Xavari/Projekt-robota-typu-SCARA/Złożenie.png

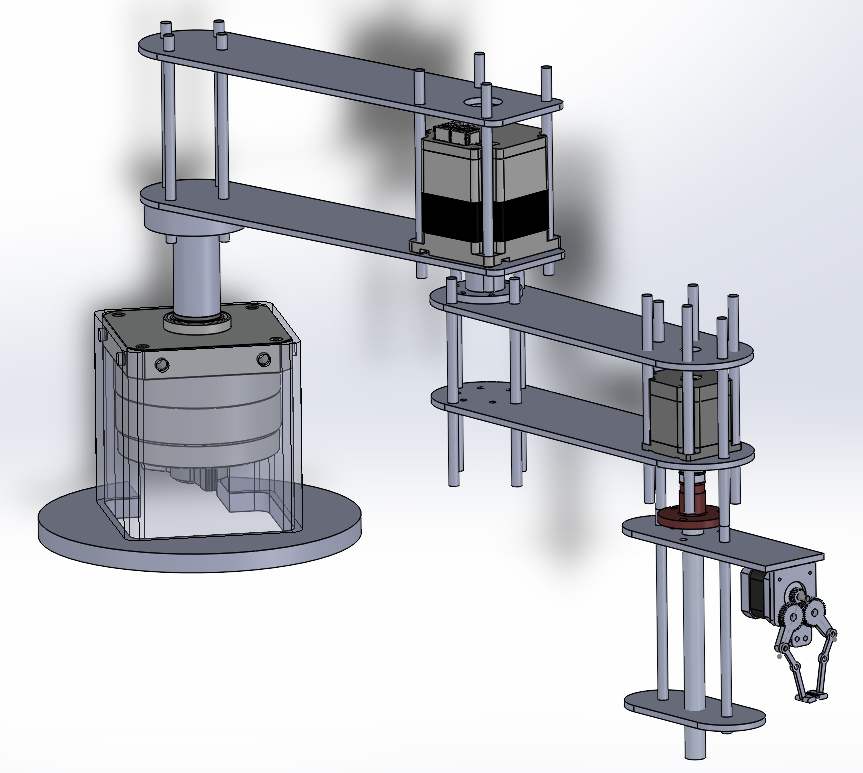
Złożenie.png
