Xavari/Projekt-robota-typu-SCARA/załączniki/screeny/5.png

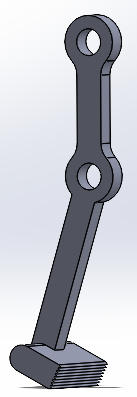
załączniki/screeny/5.png
