Xavari/Projekt-robota-typu-SCARA/README.md

# Projekt-robota-typu-SCARA
Praca ta zakłada zaprojektowanie robota typu SCARA wraz z wykonaniem odpowiednich symulacji w programie MATLAB. Wszelkie modele trójwymiarowe zostały wykonane za pomocą programu SolidWorks.
