Xavari/Projekt-robota-typu-SCARA/załączniki/Oznaczenia.png

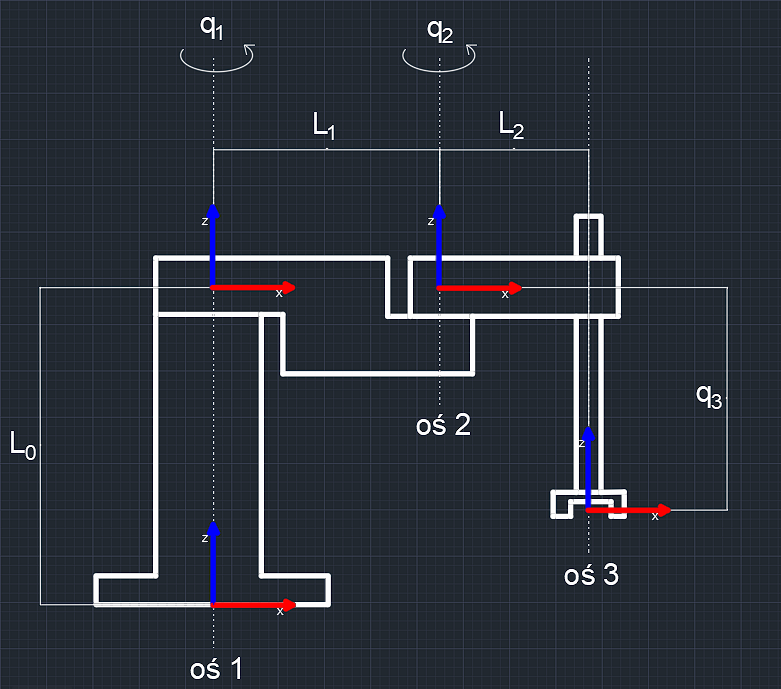
załączniki/Oznaczenia.png
