Xavari/Projekt-robota-typu-SCARA/załączniki/screeny/1.png

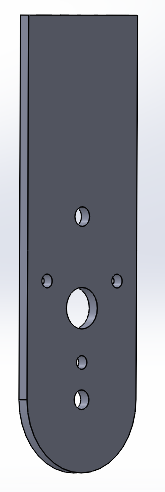
załączniki/screeny/1.png
