Xavari/Projekt-robota-typu-SCARA/załączniki/screeny/2.png

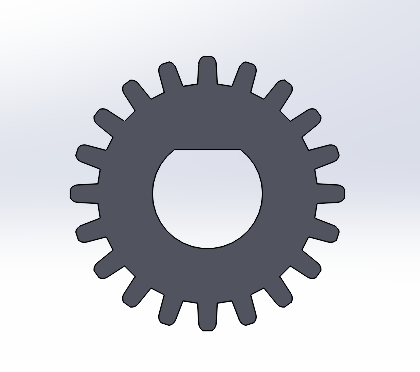
załączniki/screeny/2.png
