Xavari/Projekt-robota-typu-SCARA/załączniki/screeny/3.png

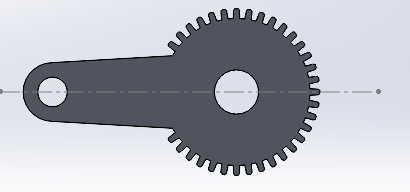
załączniki/screeny/3.png
