Xavari/Projekt-robota-typu-SCARA/załączniki/screeny/4.png

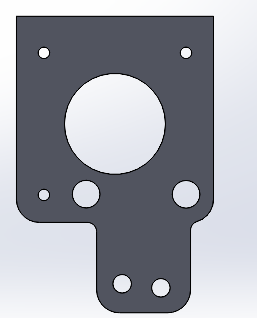
załączniki/screeny/4.png
