Xavari/Projekt-robota-typu-SCARA/załączniki/screeny/6.png

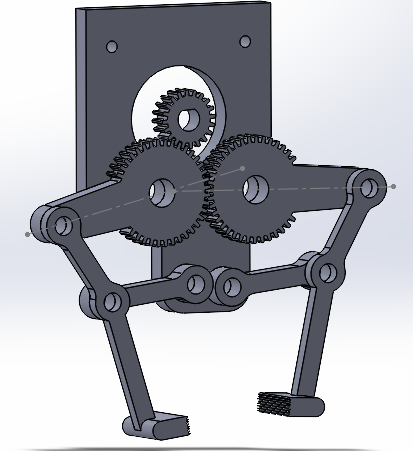
załączniki/screeny/6.png
