Xavari/Projekt-robota-typu-SCARA/załączniki/screeny/7.png

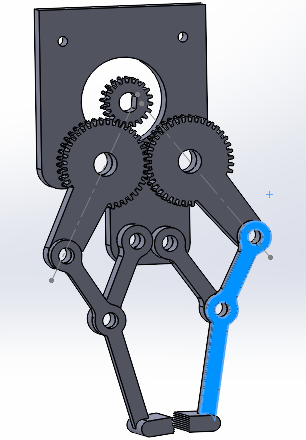
załączniki/screeny/7.png
