Xavari/Projekt-robota-typu-SCARA/załączniki/screeny/badanie ruchi_M_obr_os2.png

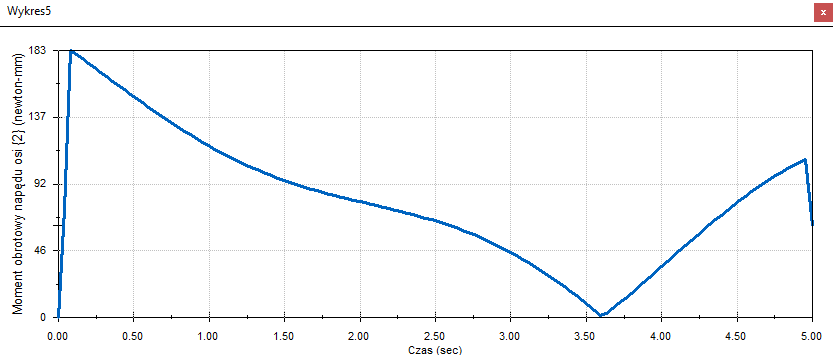
załączniki/screeny/badanie ruchi_M_obr_os2.png
