Xavari/Projekt-robota-typu-SCARA/załączniki/screeny/badanie ruchi_pr_k_chw.png

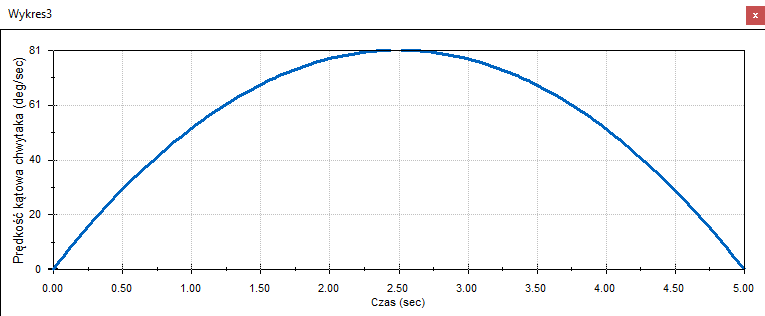
załączniki/screeny/badanie ruchi_pr_k_chw.png
