Xavari/Projekt-robota-typu-SCARA/załączniki/screeny/badanie ruchi_przemieszczenie.png

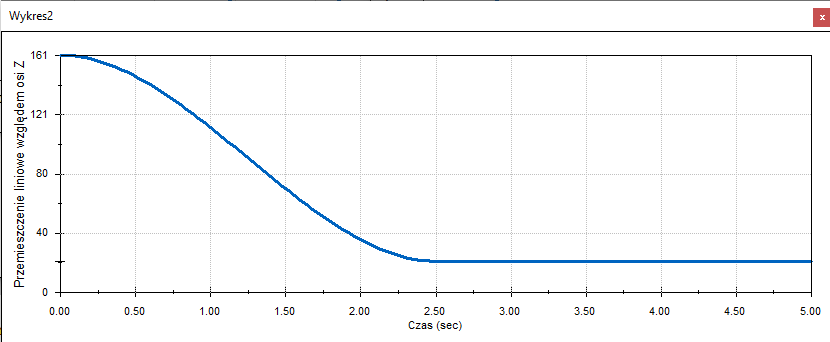
załączniki/screeny/badanie ruchi_przemieszczenie.png
