Xavari/Projekt-robota-typu-SCARA/załączniki/screeny/final1.png

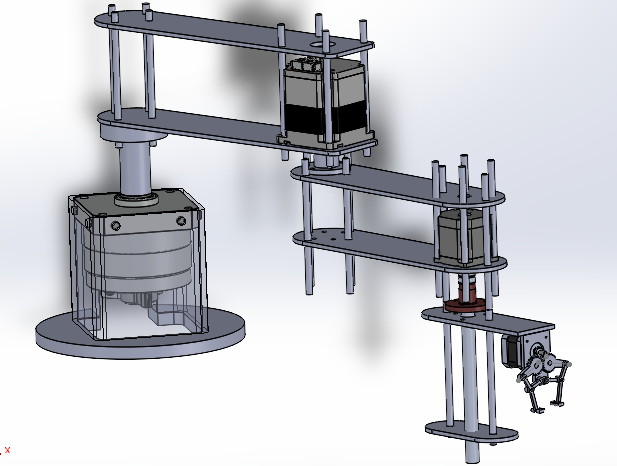
załączniki/screeny/final1.png
