Xavari/Projekt-robota-typu-SCARA/załączniki/AutoCAD/Drawing1-Model.pdf

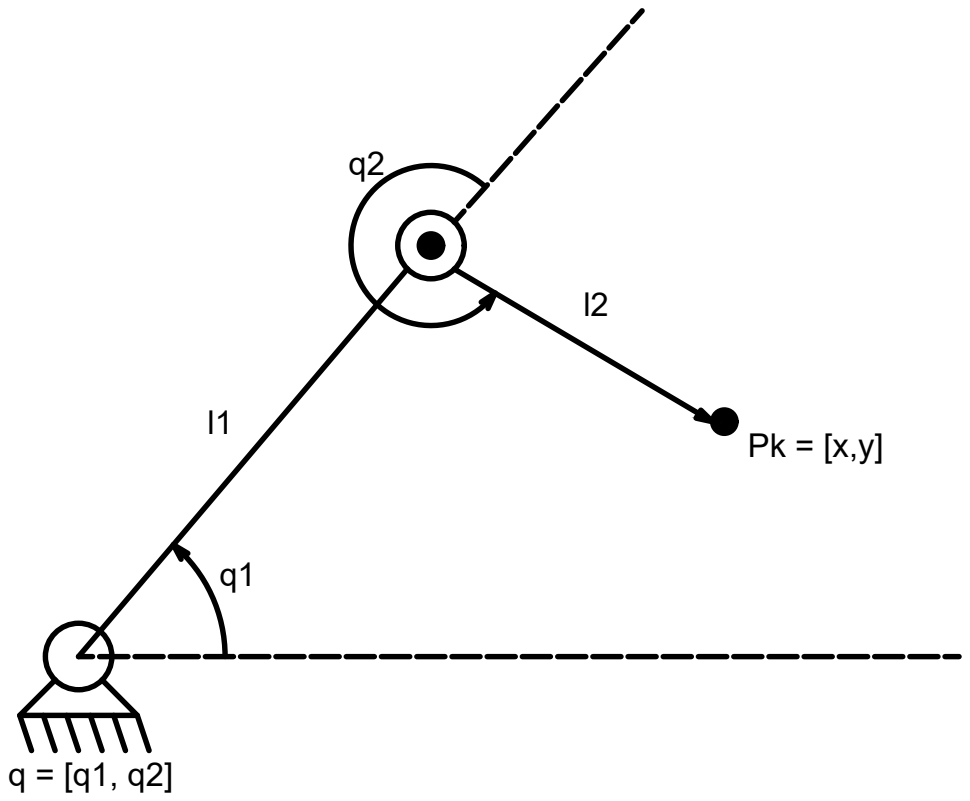
[picture p49: page 1]
