Xavari/Projekt-robota-typu-SCARA/załączniki/rysunek koncepcyjny OOP/koncept.SLDASM

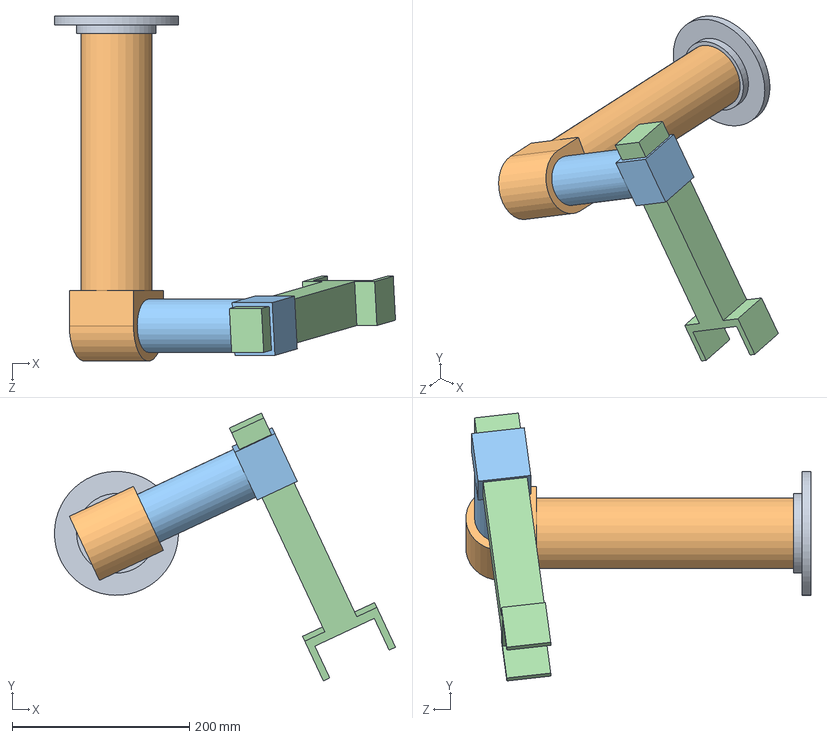
[picture p39: CAD file, 2024-03-20]
załączniki/rysunek koncepcyjny OOP/koncept.SLDASM
385.4 x 302.7 x 389.8 mm
podstawa_koncept
c1_koncept
c2_koncept
c3_koncept
