Xavari/Projekt-robota-typu-SCARA/załączniki/rysunek koncepcyjny SCARA/SCARA.SLDASM

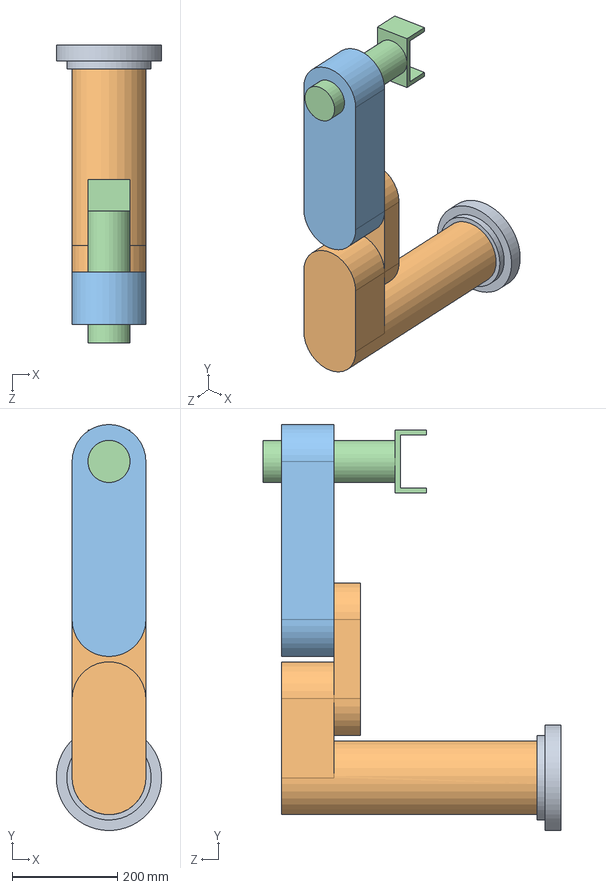
[picture p40: CAD file, 2024-03-20]
załączniki/rysunek koncepcyjny SCARA/SCARA.SLDASM
200.0 x 770.0 x 564.3 mm
C0
C1
C2
C3
