Xavari/Projekt-robota-typu-SCARA/załączniki/rysunek koncepcyjny OOP/c2_koncept.SLDPRT

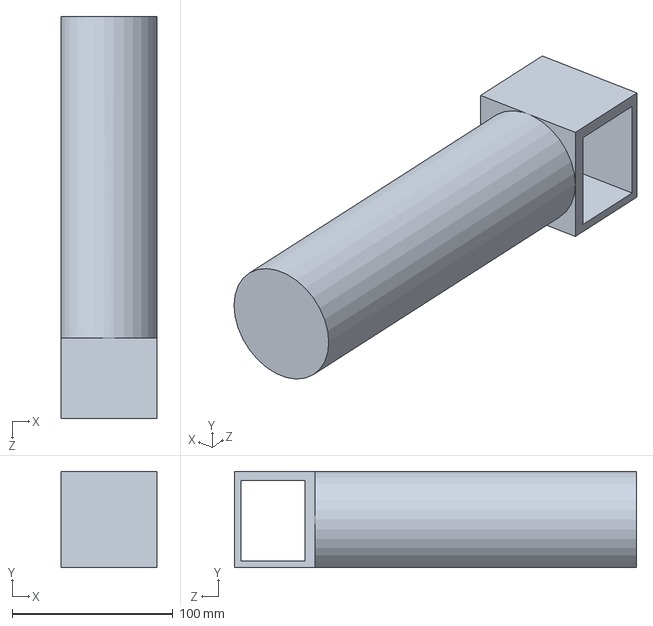
[picture p41: CAD file, 2024-03-20]
załączniki/rysunek koncepcyjny OOP/c2_koncept.SLDPRT
60.0 x 60.0 x 250.0 mm
