Xavari/Projekt-robota-typu-SCARA/załączniki/rysunek koncepcyjny SCARA/C2.SLDPRT

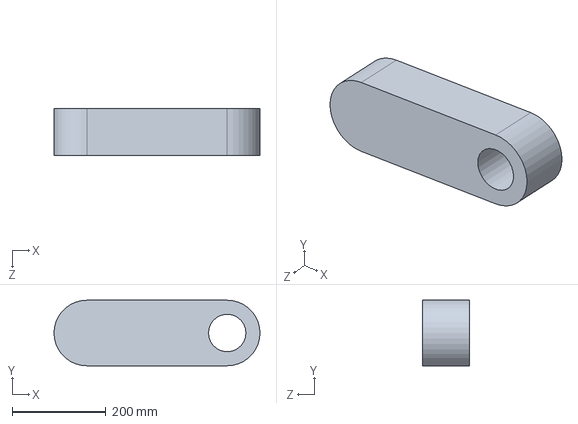
[picture p42: CAD file, 2024-03-20]
załączniki/rysunek koncepcyjny SCARA/C2.SLDPRT
440.0 x 140.0 x 100.0 mm
