Xavari/Projekt-robota-typu-SCARA/załączniki/rysunek koncepcyjny OOP/podstawa_koncept.SLDPRT

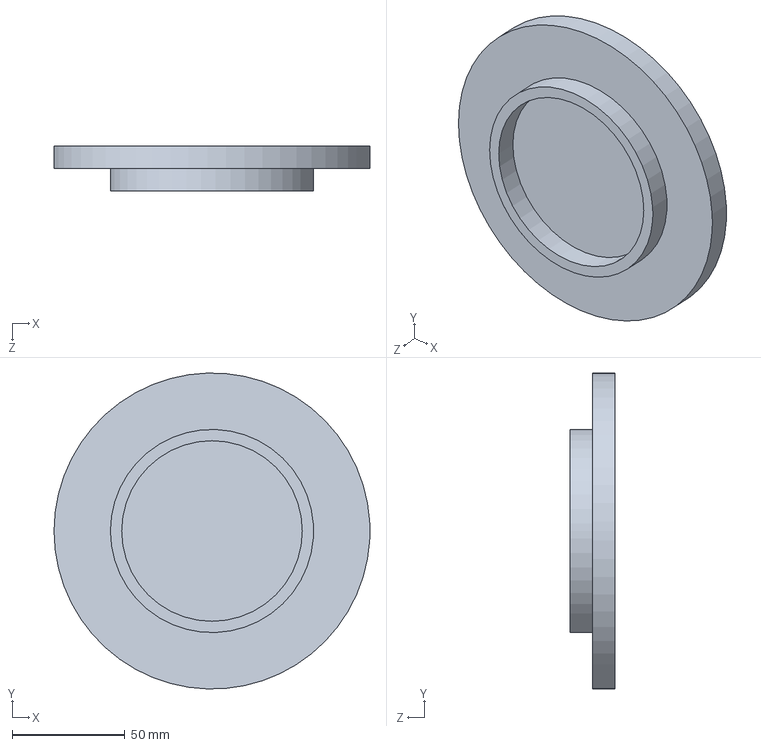
[picture p43: CAD file, 2024-03-20]
załączniki/rysunek koncepcyjny OOP/podstawa_koncept.SLDPRT
140.0 x 139.9 x 20.0 mm
