Xavari/Projekt-robota-typu-SCARA/załączniki/rysunek koncepcyjny SCARA/C0.SLDPRT

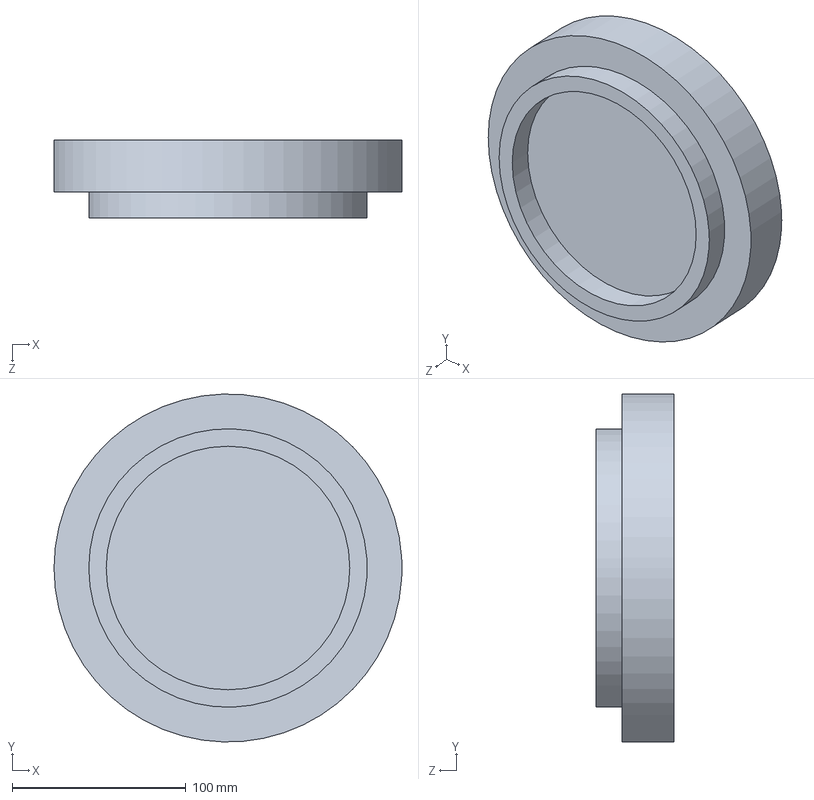
[picture p44: CAD file, 2024-03-20]
załączniki/rysunek koncepcyjny SCARA/C0.SLDPRT
200.0 x 199.9 x 45.0 mm
