Xavari/Projekt-robota-typu-SCARA/załączniki/rysunek koncepcyjny OOP/c1_koncept.SLDPRT

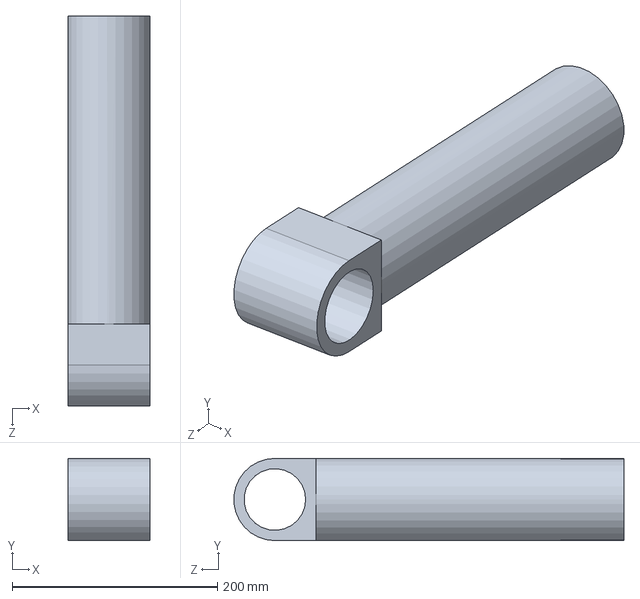
[picture p45: CAD file, 2024-03-20]
załączniki/rysunek koncepcyjny OOP/c1_koncept.SLDPRT
80.0 x 80.0 x 379.8 mm
