Xavari/Projekt-robota-typu-SCARA/załączniki/rysunek koncepcyjny SCARA/C3.SLDPRT

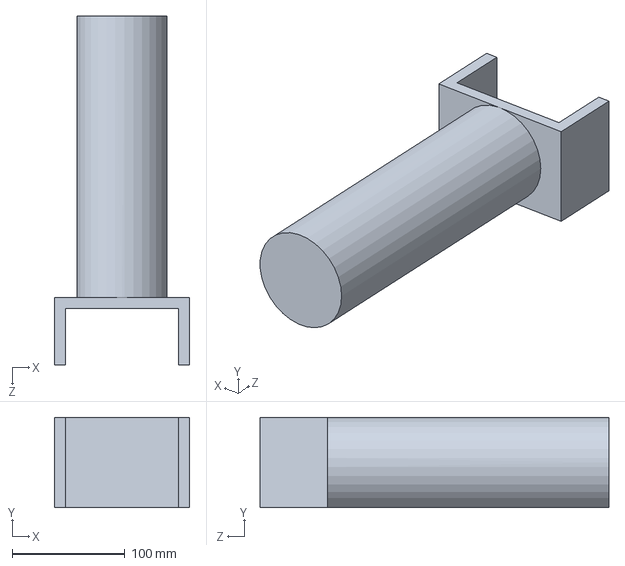
[picture p46: CAD file, 2024-03-20]
załączniki/rysunek koncepcyjny SCARA/C3.SLDPRT
120.0 x 80.0 x 310.0 mm
