Xavari/Projekt-robota-typu-SCARA/załączniki/rysunek koncepcyjny OOP/c3_koncept.SLDPRT

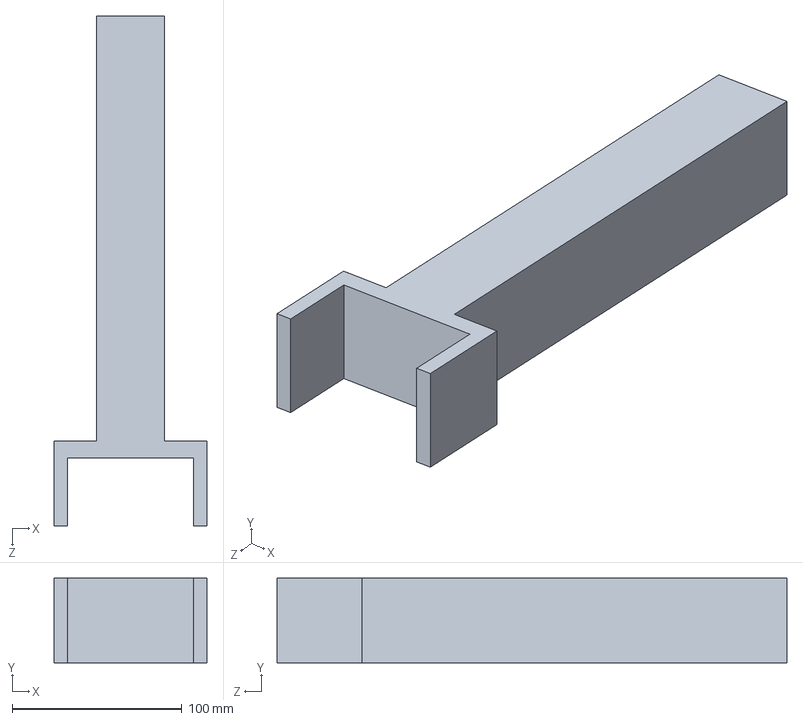
[picture p47: CAD file, 2024-03-20]
załączniki/rysunek koncepcyjny OOP/c3_koncept.SLDPRT
90.0 x 50.0 x 300.0 mm
