Xavari/Projekt-robota-typu-SCARA/załączniki/rysunek koncepcyjny SCARA/C1.SLDPRT

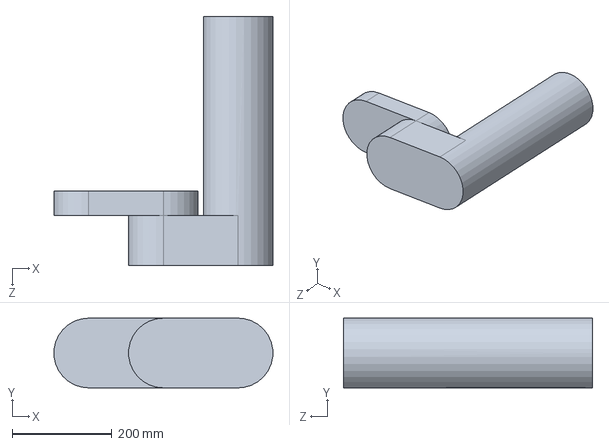
[picture p48: CAD file, 2024-03-20]
załączniki/rysunek koncepcyjny SCARA/C1.SLDPRT
439.6 x 140.0 x 500.0 mm
