Xavari/Projekt-robota-typu-SCARA/(list of files, cad)

Other CAD files:
załączniki/AutoCAD/Drawing1.dwg
załączniki/rysunek koncepcyjny SCARA/SCARA.dwg
